omarmarei05-rrrr/home_intrusion_system_Nexus/stm32_security_system Final.pptx

STM32-Based Smart Home

Security System

A low-cost, open-source embedded security platform built on STM32F411 + FreeRTOS + ESP32 + GSM

Embedded Systems Engineering Project

Team Members: Omar Marei , Omar Saleh , Omar Khaled , Reem Akram , Yousef Emad

Supervisor: Dr. Amr Fahmy

Institution: Arab Academy For science and technology – College of engineering –Computer department

2025 – 2026

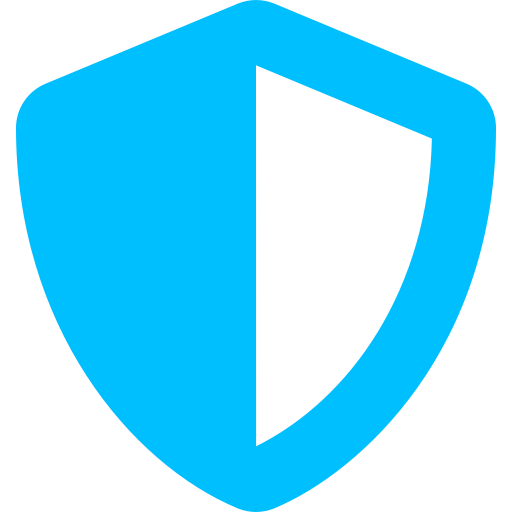
[picture p1: figure]

STM32F411

FreeRTOS

SIM800L GSM

ESP32

FSM Architecture

## Slide 2

The Problem

Why traditional home security falls short

Expensive & Proprietary

Commercial systems cost thousands with vendor lock-in and recurring monthly fees.

Complex Installation

Professional installation required. Not DIY-friendly or easily reconfigured.

Limited Customization

Rigid feature sets. No ability to add sensors, change logic, or adapt to needs.

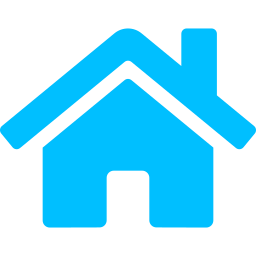
[picture p2: figure]
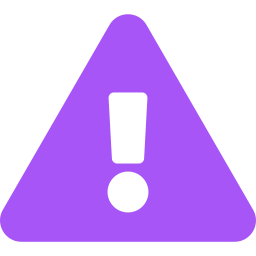
[picture p3: figure]
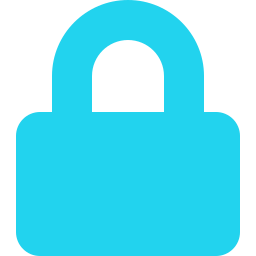
[picture p4: figure]

What the market needs → Low-cost DIY solution · Remote alerting · Full local control · Open & customizable

## Slide 3

Our Solution

STM32-Based Modular Smart Home Security System

UI / Remote Control Layer

LCD Display · Keypad · ESP32 (Wi-Fi / BT)

4

Communication Layer

GSM SIM800L · UART · ESP32 UART Bridge

3

Processing & Logic Layer

STM32F411 Black Pill · FreeRTOS · FSM Core

2

Sensing & Actuation Layer

PIR Sensor · Magnetic Switch · Buzzer

A fully open, modular embedded security platform — no cloud dependency, no proprietary hardware.

1

## Slide 4

Team Structure

Roles & responsibilities across the project

Embedded Development

STM32 firmware, FreeRTOS tasks, FSM logic, sensor drivers

Hardware Integration

Circuit design, wiring, relay, buzzer, PIR, magnetic switch

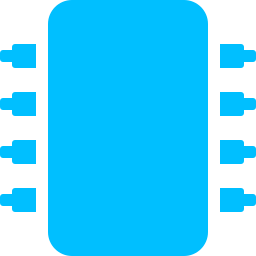
[picture p5: figure]
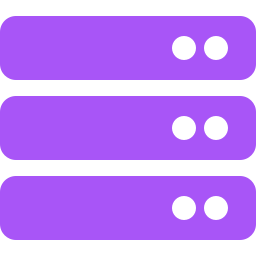
[picture p6: figure]

GSM Communication

SIM800L integration, AT commands, SMS alert pipeline

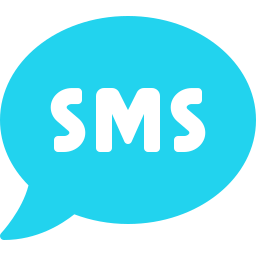
[picture p7: figure]

UI/UX & ESP32 Module

LCD interface, keypad input, ESP32 Wi-Fi/BT remote control

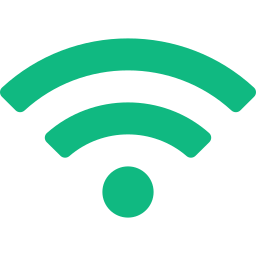
[picture p8: figure]

Every team member responsible for end-to-end delivery of their module.

## Slide 5

Development Timeline

Six-phase iterative development roadmap

01

Component Testing

Validate sensors, GSM, LCD individually

02

FSM Implementation

Core state machine: IDLE, ARMED, ALERT, DISARMED

03

GSM Integration

SIM800L AT commands, SMS alert dispatch

04

UI Development

LCD display, keypad PIN entry, user feedback

05

FreeRTOS Migration

Multi-task architecture, semaphores, queues

06

ESP32 Integration

Wi-Fi / Bluetooth remote arm/disarm module

## Slide 6

Key Features

Full-spectrum embedded security capabilities

Motion Detection

PIR sensor detects intrusion in real-time

Door Sensing

Magnetic switch on entry points

SMS Alerts

Instant GSM notifications via SIM800L

PIN Keypad Control

Secure arm/disarm via numeric keypad

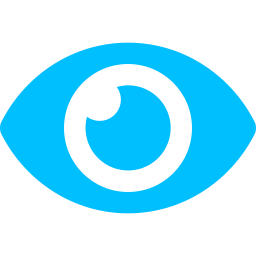
[picture p9: figure]
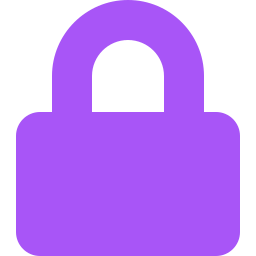
[picture p10: figure]
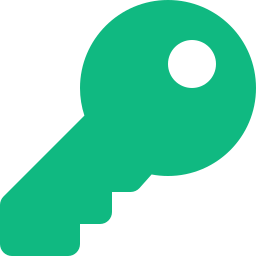
[picture p11: figure]

LCD Interface

Real-time status and feedback display

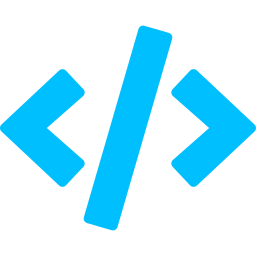
[picture p12: figure]

Entry Delay System

Configurable delay before alert fires

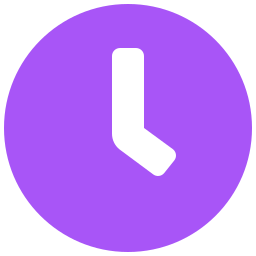
[picture p13: figure]

Buzzer & LED Alerts

Local audible and visual alarm output

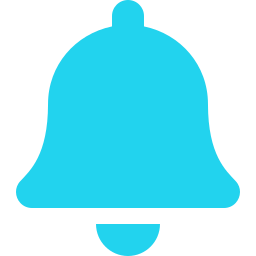
[picture p14: figure]

Wi-Fi / BT Remote

ESP32 enables wireless arm/disarm control

## Slide 7

System Specifications

Hardware components & software stack

HARDWARE

- STM32F411 Black Pill (MCU)
- PIR Sensor – HC-SR501
- Magnetic Door Switch
- SIM800L GSM Module
- ESP32 Wi-Fi / Bluetooth Module
- 16×2 LCD Display (I2C)
- 4×4 Matrix Keypad
- Active Buzzer

SOFTWARE

- Arduino IDE + STM32duino
- FreeRTOS (real-time multitasking)
- hd44780 LCD Library
- UART Serial Communication
- FSM Architecture (state machine)
- AT Command Protocol (GSM)
- ESP32 Arduino Framework

## Slide 8

Results & Achievements

Validation outcomes from system testing

Real-Time Detection

< 1s

Intrusion response latency

SMS Alert Reliability

100%

Delivery success in testing

FSM Stability

Stable

All state transitions verified

FreeRTOS Multitasking

5 Tasks

Concurrent tasks operational

ESP32 Remote Control

✓ Live

Wireless arm/disarm functional

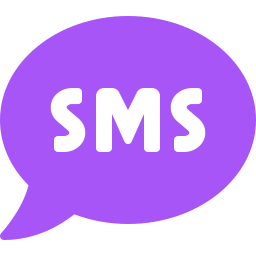
[picture p15: figure]
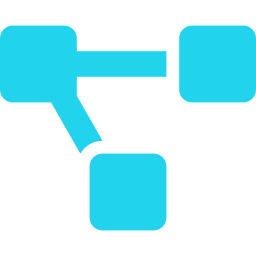
[picture p16: figure]
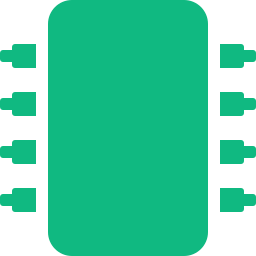
[picture p17: figure]
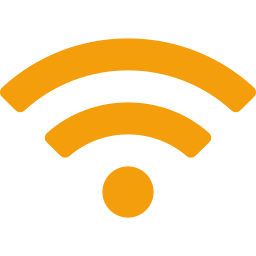
[picture p18: figure]

All core system features validated through end-to-end integration testing.

## Slide 9

Project Repository

Source code, drivers, and documentation — all open

github.com / your-username / STM32-Smart-Home-Security

⭐ Star the repo · Fork to contribute · Open issues for feedback

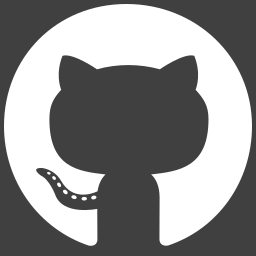
[picture p19: figure]

~/STM32-Smart-Home-Security

STM32-Smart-Home-Security/
├── /Core # STM32 main application, FSM logic, task handlers
├── /Drivers # Peripheral drivers: PIR, LCD, keypad, buzzer, relay
├── /RTOS # FreeRTOS configuration, task definitions, queues
├── /ESP32 # ESP32 firmware for Wi-Fi / Bluetooth remote module
└── /Docs # Circuit diagrams, FSM diagram, AT command logs, wiring

## Slide 10

Documentation & Resources

Everything needed to build, replicate, and extend the system

Circuit Diagrams

Full schematic: STM32 to all peripherals with pin mapping and power rails

FSM Diagram

State machine: IDLE → ARMED → INTRUSION → ALERT → DISARMED transitions

Wiring Guide

Step-by-step connection diagram for each hardware module with notes

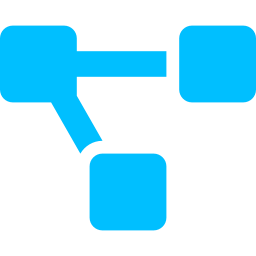
[picture p20: figure]
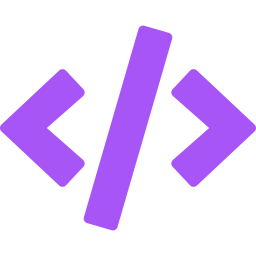
[picture p21: figure]
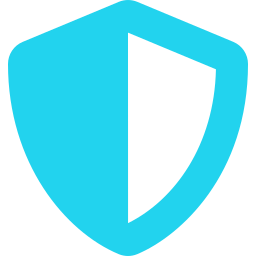
[picture p22: figure]

AT Command Logs

Captured GSM AT command sequences for SIM800L setup and SMS dispatch

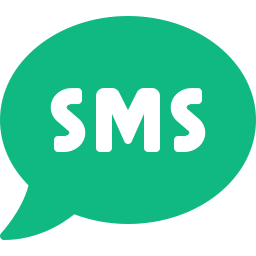
[picture p23: figure]

Project Report

Full technical report: architecture, design decisions, test results

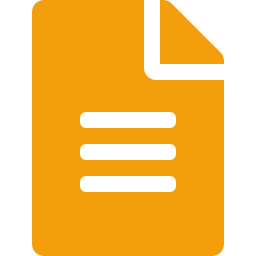
[picture p24: figure]

Setup Guide

Getting started: flashing firmware, configuring ESP32, testing the system

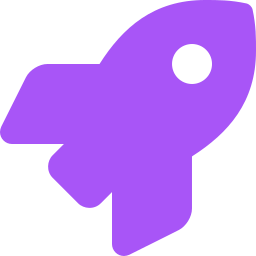
[picture p25: figure]

All assets available in the /Docs folder of the project repository.

## Slide 11

Conclusion & Future Scope

What was built — and where it can go

WHAT WE BUILT

- Low-cost, fully open DIY security system
- Reliable FSM-driven embedded architecture
- Real-time intrusion detection & SMS alerting
- Scalable multi-task FreeRTOS firmware
- Wireless remote control via ESP32

FUTURE WORK

Mobile App Integration (iOS / Android)

Cloud Connectivity (MQTT / AWS IoT)

AI-Based Intrusion Detection (Edge ML)

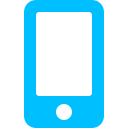
[picture p26: figure]
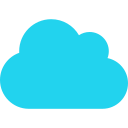
[picture p27: figure]
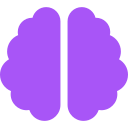
[picture p28: figure]

Thank You

Questions & Discussion · github.com/your-username/STM32-Smart-Home-Security
