omarmarei05-rrrr/home_intrusion_system_Nexus/(commit log)

2026-06-03 Initial commit - STM32 IDS project
2026-06-04 Update STM32.ino
    Removed commented header and unnecessary comments to clean up the code.
